cnlohr/esplocalizer/(threads)

Thread 1 (2016-12-31):

Which LDO did you use?

hannes-angst, 2016-12-31:
Can you please expose more information on the parts you used? Especially the LDO you used.

cnlohr, 2017-01-01:
I could go into it more, but I used the MCP1824 to allow seamless switch-over when USB power is provided so it doesn't discharge through the battery when it charges.   There are a lot of other non-latching LDOs with disable, but, I've used the MCP so long, figured I'd just keep using it.

Thread 2 (2017-01-06):

Autoimporting KiCad pretty footprints from hardware/*.sch

brainstorm, 2017-01-06:
Hello @cnlohr,

Thanks much for publishing your projects as open hardware as well as the firmware, always inspiring stuff to learn from you.

I have been trying to reuse your `.sch` since I have a couple of modifications in mind to your design.

Sorry if this sounds obvious (I'm a relatively new KiCad user), but how can I auto-import the footprints for pcbnew without manually importing each `.pretty` library/module? as the KiCad docs state, i.e:

https://github.com/jdunmire/kicad-ESP8266

I thought about giving this giant meta-pretty-repo a shot, but the ESP footprint doesn't seem to be there:

https://github.com/monostable/kicad_footprints

I understand you might be using your existing installation/footprints from past projects, but what would be your advice to semi-automate this process of importing footprints?

brainstorm, 2017-01-06:
I also meant including the `.pro`, `.lib`, etc files from KiCad like in the ESPUSB project:

https://github.com/cnlohr/espusb/tree/master/hardware/usb_8285

Also, totally understand if you don't want to release those yet before monetizing some boards a bit more through ebay, happy to start from scratch myself instead ;)

brainstorm, 2017-01-06:
Hold on a minute... you are adding LoRa (RFM95W radio) to a sister board, that is so cool!!! Exactly what I wanted to do for my own board!

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

Closing this issue since I'm going on my own with KiCad from scratch, but would really appreciate forking/refactoring esplocalizer's hardware (instead of dealing with `??` and unresolved symbols/components from the bare `.sch` file)... is there a kicad-utils script or similar that helps resolving/downloading those?

cnlohr, 2017-01-09:
That seems odd... It should be able to pull the footprints from the cache.   Perhaps I forgot to include the cache?

cnlohr, 2017-01-09:
Looks like I did!  Fixed.

brainstorm, 2017-01-09:
Awesome, thanks Charles! The eeschema looks great now with the cached file (no more `??`'d components). The netlist can be generated without problems but it seems like `Cvpcb` is not liking the part assignments/mappings:

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

cnlohr, 2017-01-09:
I believe most of them are in my public repository here: https://cnlohr.net/pubsvn/electrical/kicad/

Did you tell KiCad to download all footprints locally?  If not, you should.  It should give you the common parts like SM0603 and SOT23-5

brainstorm, 2017-01-09:
Thanks Charles for following this up, super appreciated.

I found that svn a while later exploring, but then I switched to building my own board from scratch since I want to remove/change quite a few components and get more acquainted with KiCad.

Btw, if you ever move that repo to github, let me know, happy to include it to this semi-automated community repo, I've been using it recently, really handy:

https://github.com/monostable/kicad_footprints

cnlohr, 2017-01-09:
I might, but, it's one of those things I like to keep on my own because I know where everything I need is.

Closed 2017-01-06.

Thread 3 (2017-01-20):

Fails to start wifi

fmaurer, 2017-01-20:
New install following instructions, cloned esp82XX-basic example, successfully flash firmware with "make burn" and "make burnweb" (no errors), but doesn't start a wifi hotspot. Serial output on reset shows:

```
esp82XX Web-GUI
Version: v0.1-7-g06742-dev - Build Thu Jan 19 20:05:33 PST 2017 with -DICACHE_FLASH -DWEB_PORT=80 -DCOM_PORT=7777 -DBACKEND_PORT=7878  -DSLOWTICK_MS=5Loading Settings: af / 0 / 69 / 69
Settings Loaded: ESP_930A72 / Default
Opmode: 0
Boot Ok.
```

I'm not sure how to debug why the Opmode would be 0 (wifi off) for this example project. Any pointers would be really helpful, thank you!

On MacOS 10.12

cnlohr, 2017-01-20:
I am not sure how it got into opmode 0.

Try pressing and holding the PGM (GPIO0) button down for about 5 seconds, then releasing.  It should reboot into SoftAP mode.

Charles

fmaurer, 2017-01-20:
You did it! Thank you a million :)  Had to hold closer to 10 seconds but after I let go PGM button wireless AP showed up and serial output:

```
ets Jan  8 2013,rst cause:2, boot mode:(3,7)

load 0x40100000, len 28272, room 16
tail 0
chksum 0x85
load 0x3ffe8000, len 884, room 8
tail 12
chksum 0x59
ho 0 tail 12 room 4
load 0x3ffe8380, len 2612, room 12
tail 8
chksum 0xb2
csum 0xb2
don't use rtc mem data
rlN5
    esp82XX Web-GUI
Version: v0.1-7-g06742-dev - Build Thu Jan 19 20:05:33 PST 2017 with -DICACHE_FLASH -DWEB_PORT=80 -DCOM_PORT=7777 -DBACKEND_PORT=7878  -DSLOWTICK_MS=5Loading Settings: af / 0 / 69 / 69
                Settings Loaded: ESP_930A72 / Default
                                                     Opmode: 2
                                                              Default SoftAP mode: "ESP_930A72":""
                                                                                                  Boot Ok.
                                                                                                          IGMP Joining: 0104a8c0 fb0000e0
```

I'm putting together Mac OS setup guide, will make note of this.

cnlohr, 2017-01-20:
That would be really awesome!  Thanks!

Closed 2017-01-20.

Thread 4 (2017-01-20):

esplocalizer firmware-c example missing files

fmaurer, 2017-01-20:
Cloned esp82XX-basic example compiled and flashed to esp without issue. Everything works great.

Unable to do `make all` in /esplocalizer/firmware-c, compiler missing 'lib' files. What does libmain.a do and where can I get it :) ?

```
xtensa-lx106-elf-gcc: error: /Volumes/case-sensitive/esp-open-sdk/lib/libmain.a: No such file or directory
xtensa-lx106-elf-gcc: error: /Volumes/case-sensitive/esp-open-sdk/lib/liblwip.a: No such file or directory
xtensa-lx106-elf-gcc: error: /Volumes/case-sensitive/esp-open-sdk/lib/libssl.a: No such file or directory
xtensa-lx106-elf-gcc: error: /Volumes/case-sensitive/esp-open-sdk/lib/libupgrade.a: No such file or directory
xtensa-lx106-elf-gcc: error: /Volumes/case-sensitive/esp-open-sdk/lib/libnet80211.a: No such file or directory
xtensa-lx106-elf-gcc: error: /Volumes/case-sensitive/esp-open-sdk/lib/libwpa.a: No such file or directory
xtensa-lx106-elf-gcc: error: /Volumes/case-sensitive/esp-open-sdk/lib/libphy.a: No such file or directory
xtensa-lx106-elf-gcc: error: /Volumes/case-sensitive/esp-open-sdk/lib/liblwip.a: No such file or directory
xtensa-lx106-elf-gcc: error: /Volumes/case-sensitive/esp-open-sdk/lib/libcrypto.a: No such file or directory
xtensa-lx106-elf-gcc: error: /Volumes/case-sensitive/esp-open-sdk/lib/libpp.a: No such file or directory
```

fmaurer, 2017-01-21:
Copied /lib and /ld from here https://github.com/espressif/ESP8266_RTOS_SDK

```
$ make all
/Volumes/case-sensitive/esp-open-sdk/xtensa-lx106-elf/bin/xtensa-lx106-elf-gcc -mlongcalls -Os -I/Volumes/case-sensitive/esp-open-sdk/include -Iesp82xx/include -I. -Iesp82xx/fwsrc -Iuser -DICACHE_FLASH -DWEB_PORT=80 -DCOM_PORT=7777 -DBACKEND_PORT=7878  -DSLOWTICK_MS=50 -DVERSSTR='"Version: 5fb30-dev - Build Fri, 20 Jan 2017 18:35:48 -0800 with -DICACHE_FLASH -DWEB_PORT=80 -DCOM_PORT=7777 -DBACKEND_PORT=7878  -DSLOWTICK_MS=50"' esp82xx/fwsrc/uart.c esp82xx/fwsrc/esp82xxutil.c esp82xx/fwsrc/flash_rewriter.c esp82xx/fwsrc/http.c esp82xx/fwsrc/commonservices.c esp82xx/fwsrc/http_custom.c esp82xx/fwsrc/mdns.c esp82xx/fwsrc/mfs.c user/custom_commands.c user/user_main.c user/i2c.c user/promiscuous.c -flto -Wl,--relax -Wl,--gc-sections -nostdlib -L/Volumes/case-sensitive/esp-open-sdk/lib -L/Volumes/case-sensitive/esp-open-sdk/xtensa-lx106-elf/lib/gcc/xtensa-lx106-elf/4.8.5/libgcc.a /Volumes/case-sensitive/esp-open-sdk/lib/libmain.a /Volumes/case-sensitive/esp-open-sdk/lib/liblwip.a /Volumes/case-sensitive/esp-open-sdk/lib/libssl.a /Volumes/case-sensitive/esp-open-sdk/lib/libupgrade.a /Volumes/case-sensitive/esp-open-sdk/lib/libnet80211.a /Volumes/case-sensitive/esp-open-sdk/lib/libwpa.a /Volumes/case-sensitive/esp-open-sdk/lib/libphy.a /Volumes/case-sensitive/esp-open-sdk/lib/liblwip.a /Volumes/case-sensitive/esp-open-sdk/lib/libcrypto.a /Volumes/case-sensitive/esp-open-sdk/lib/libpp.a /Volumes/case-sensitive/esp-open-sdk/xtensa-lx106-elf/lib/gcc/xtensa-lx106-elf/4.8.5/libgcc.a -T /Volumes/case-sensitive/esp-open-sdk/ld/eagle.app.v6.ld -B/Volumes/case-sensitive/esp-open-sdk/lib  -o image.elf
/Volumes/case-sensitive/esp-open-sdk/xtensa-lx106-elf/lib/gcc/xtensa-lx106-elf/4.8.5/../../../../xtensa-lx106-elf/bin/ld: image.elf section `.text' will not fit in region `iram1_0_seg'
/Volumes/case-sensitive/esp-open-sdk/xtensa-lx106-elf/lib/gcc/xtensa-lx106-elf/4.8.5/../../../../xtensa-lx106-elf/bin/ld: region `iram1_0_seg' overflowed by 3880 bytes
```

I read this had to do with SDK > 1.5.2, but I thought I solved this with esp-open-sdk/Makefile

#VENDOR_SDK = 2.0.0
VENDOR_SDK = 1.5.2

> e.g. with SDK versions greater than 1.5.2, Espressif changed the IRAM management

I'm not sure if coping /lib and /ld was the right thing to do or is even related...

cnlohr, 2017-01-21:
and /include.   Typically I keep the whole SDK together and rename the SDKs.

Indeed that is the issue, however, Espressif made a new SDK that should work again.   You can get a pre-release version of it from here https://github.com/cnlohr/swadges2017 - the file called angus_patch.

Charles

fmaurer, 2017-01-21:
- added /include folder
- downloaded and linked prerelease SDK in esp-open-sdk/Makefile, as seen here:

```
# Vendor SDK version to install, see VENDOR_SDK_ZIP_* vars below
# for supported versions.
VENDOR_SDK = 2.0.0
#VENDOR_SDK = 1.5.2

#...

VENDOR_SDK_ZIP_2.0.0 = REDUCED_ESP8266_NONOS_SDK_2.0.0_20160810_with_angus_patch.zip
VENDOR_SDK_DIR_2.0.0 = REDUCED_ESP8266_NONOS_SDK_2.0.0_20160810_with_angus_patch
#VENDOR_SDK_ZIP_2.0.0 = ESP8266_NONOS_SDK_V2.0.0_16_08_10.zip
#VENDOR_SDK_DIR_2.0.0 = ESP8266_NONOS_SDK_V2.0.0_16_08_10

#the rest of the file...
```

- run `make all `
- cd to /esplocalizer/firmware-c
- `make all` gives same iram error

I'm not understanding where the esp82XX-basic example differs so much from the esplocalizer/firmware-c to produce this behavior. Both project's user.cfg have:

`SDK          = /Volumes/case-sensitive/esp-open-sdk`

Just tried a `make burnweb` using angus SDK and esp82XX-basic produced no errors.

Could you elaborate on "keep the whole SDK together and rename the SDKs" ? Do you keep the esp-open-sdk inside of esplocalizer?

My directory structure looks like this /Volumes/case-sensitive :
- esp-open-sdk
- esp82XX-basic
- esplocalizer

fmaurer, 2017-01-22:
Fixed it:

First was my mistake forgetting command is `make burnweb` while in /esplocalizer/firmware-c

However, this isn't all, it produced the following error:
`Auto-detected Flash size: 32m
Running Cesanta flasher stub...

A fatal error occurred: Invalid head of packet ('\xd8')`

This was fixed by commenting out the following line in /esplocalizer/firmware-c/user.cfg

#FWBURNFLAGS  = -b 1000000

cnlohr, 2017-01-23:
Which dongle do you have?

fmaurer, 2017-01-23:
PL2303 TA based cable, using 2 level shifters for 3.3V and RX

https://www.amazon.com/gp/product/B00QT7LQ88/ref=oh_aui_search_detailpage?ie=UTF8&psc=1

cnlohr, 2017-01-23:
Aah! Ok, I think that one works better at 1,500,000 baud.  Dunno why.

Charles

fmaurer, 2017-01-23:
In my infinite n00bness I have misunderstood many things, but learned much.

make burnweb and make burn accomplish different things. I was able to get burnweb to work as expected, but not `make burn`. This may explain why I couldn't get the fast acc CSV file to work: https://github.com/cnlohr/esplocalizer/issues/5 The esp hasn't been flashed to talk with IMU firmware code. All it has is the web GUI

It's the same `iram1_0_seg` error which I mistook as being fixed by using an older SDK.

My /esp-open-sdk is compiled for 1.5.1, but that still produces same error. Next I'll try cnlohr's suggestion to keep SDK together and rename multiple SDKs.

```
$ make burn
/Volumes/case-sensitive/esp-open-sdk/xtensa-lx106-elf/bin/xtensa-lx106-elf-gcc -mlongcalls -Os -I/Volumes/case-sensitive/esp-open-sdk/include -Iesp82xx/include -I. -Iesp82xx/fwsrc -Iuser -DICACHE_FLASH -DWEB_PORT=80 -DCOM_PORT=7777 -DBACKEND_PORT=7878  -DSLOWTICK_MS=50 -DVERSSTR='"Version: 5fb30-dev - Build Mon, 23 Jan 2017 13:50:12 -0800 with -DICACHE_FLASH -DWEB_PORT=80 -DCOM_PORT=7777 -DBACKEND_PORT=7878  -DSLOWTICK_MS=50"' esp82xx/fwsrc/uart.c esp82xx/fwsrc/esp82xxutil.c esp82xx/fwsrc/flash_rewriter.c esp82xx/fwsrc/http.c esp82xx/fwsrc/commonservices.c esp82xx/fwsrc/http_custom.c esp82xx/fwsrc/mdns.c esp82xx/fwsrc/mfs.c user/custom_commands.c user/user_main.c user/i2c.c user/promiscuous.c -flto -Wl,--relax -Wl,--gc-sections -nostdlib -L/Volumes/case-sensitive/esp-open-sdk/lib -L/Volumes/case-sensitive/esp-open-sdk/xtensa-lx106-elf/lib/gcc/xtensa-lx106-elf/4.8.5/libgcc.a /Volumes/case-sensitive/esp-open-sdk/lib/libmain.a /Volumes/case-sensitive/esp-open-sdk/lib/liblwip.a /Volumes/case-sensitive/esp-open-sdk/lib/libssl.a /Volumes/case-sensitive/esp-open-sdk/lib/libupgrade.a /Volumes/case-sensitive/esp-open-sdk/lib/libnet80211.a /Volumes/case-sensitive/esp-open-sdk/lib/libwpa.a /Volumes/case-sensitive/esp-open-sdk/lib/libphy.a /Volumes/case-sensitive/esp-open-sdk/lib/liblwip.a /Volumes/case-sensitive/esp-open-sdk/lib/libcrypto.a /Volumes/case-sensitive/esp-open-sdk/lib/libpp.a /Volumes/case-sensitive/esp-open-sdk/xtensa-lx106-elf/lib/gcc/xtensa-lx106-elf/4.8.5/libgcc.a -T /Volumes/case-sensitive/esp-open-sdk/ld/eagle.app.v6.ld -B/Volumes/case-sensitive/esp-open-sdk/lib  -o image.elf
/Volumes/case-sensitive/esp-open-sdk/xtensa-lx106-elf/lib/gcc/xtensa-lx106-elf/4.8.5/../../../../xtensa-lx106-elf/bin/ld: image.elf section `.text' will not fit in region `iram1_0_seg'
/Volumes/case-sensitive/esp-open-sdk/xtensa-lx106-elf/lib/gcc/xtensa-lx106-elf/4.8.5/../../../../xtensa-lx106-elf/bin/ld: region `iram1_0_seg' overflowed by 3880 bytes
```

Thread 5 (2017-01-23):

Fast Acc CSV Stream is empty file

fmaurer, 2017-01-23:
I'm having trouble reading the accel and gyro data from a websocket. The default /firmware-c web interface gives a link to the CSV file, but I'm getting 0 bytes or "unable to connect" errors at /d/fastacc.csv

I'm able to create websockets to these endpoints I found in the source:
/d/ws/echo
/d/ws/evaltest
/d/ws/issue

My hunch is I'd have to create a new endpoint: /d/ws/fastacc which the ESP sends websocket packets to connected devices through.

The web interface and fastacc() in /firmware-c/user/user_main.c  looks like the device should already be sending this data, I'm not sure the endpoint to connect to or if this is a problem with my setup.

When I click on the Fast Acc CSV link in web interface, this function should write to socket. 'Save link as' doesn't make a difference:
```
static ICACHE_FLASH_ATTR void fastacc()
{
	//char mydat[128];
	//int len = URLDecode( mydat, 128, curhttp->pathbuffer+8 );

	char buf[1024];
	int times = 20;
	int len = 0;
	int16_t data[10];

	if( first_acc == 1 )
	{
		first_acc = 0;
		len += ets_sprintf( buf+len, "gx, gy, gz, ax, ay, az\r\n" );
	}

	for( ; times > 0 && lsmhead != lsmtail; times -- )
	{
		int16_t * data = &lsmdata[6*lsmtail];
		lsmtail = (lsmtail+1)%LSMBUFFERSIZE;

		len += ets_sprintf( buf+len, "%d, %d, %d, %d, %d, %d\r\n", data[0], data[1], data[2], data[3], data[4], data[5] );
	}

	if( len )
	{
		START_PACK;
		PushBlob( buf, len );
		END_TCP_WRITE( curhttp->socket );
	}

	if( i2cmode == 0 )
	{
		curhttp->state = HTTP_WAIT_CLOSE;
	}

}
```

Thread 6 (2017-04-06):

Missing annotations in schematic ( Component: U5 Regulator )

swapnil823, 2017-04-06:

cnlohr, 2017-04-06:
Which annotations? (Not sure what you mean) Do you mean pertaining to what the part actually is?  An mcp1824?

swapnil823, 2017-04-07:
Yes, An mcp1824.

Closed 2017-04-07.

Thread 7 (2017-09-10):

What is the power consumption in sleep mode?

harmverbeek, 2017-09-10:
Is it < 20 uA?
That would make it a really useful IoT device.

con-f-use, 2017-09-10:
There are different sleep modes in the esp8266, but yes, you can get in the ballpark of that but about everything on the chip will be disabled.

harmverbeek, 2017-09-10:
how about the usb uart chip and the leds?
are they also powered down?

con-f-use, 2017-09-10:
LEDs can be switched of in software or, in case of the power indicator LED desoldered on most ESP8266 modules - not all are the same. I don't know about the UART.

cnlohr, 2017-09-11:
THIS REMINDS ME!  I got permission to post a study I did on the sleeping options for the ESP on the esplocalizer!  It's really rough and totally not publish ready but here is a link to the google drive and some of the code I used.

https://drive.google.com/open?id=0B-rO-WAvEtVBU1FSOVRKZ3Npc1U

TL;DR:
 * Deep sleep on esplocaizer is 0.9mA
 * Sleeping, waiting for a GPIO wakeup is 1.8mA
 * Disconnected-from-wifi @pvvx light-sleep or as I call it "crazy sleep" where the processor is still running but not very utilized is 3.5-5.5mA depending on work load.  Thanks @pvvx you are one awesome dude.
 * Wifi on, light sleep ~12mA
 * Full bore: 72mA

cnlohr, 2017-09-11:
The real killer for suuuper tiny power consumption on this board is a combination of the regulators, and static uses.  I don't actually know how much the LEDs use, but it's not much.

harmverbeek, 2017-09-11:
0.9mA is 90 times too much for a battery powered sensor ;)
That's the problem with all sensor boards that include a USB UART chip, regulators and leds.
You have got to find a way to at least switch off the UART chip when not used.

cnlohr, 2017-09-12:
This board does not include the uart chip on it.  USB on here is strictly for power.  It's everything else on-board, including the lithium ion charging circuit.

Thread 8 (2018-02-25):

Arduino build error

meule, 2018-02-25:
When I build esp_10dof.ino using Arduini 1.8.5 I get the error:
```/var/folders/53/6tzgtd453hzgcg2hsv9j353w0000gn/T/arduino_build_876699/sketch/esp_10dof.ino.cpp.o:(.text._Z12sensor_setupv+0x10): undefined reference to `LSM9DS1::begin()'
/var/folders/53/6tzgtd453hzgcg2hsv9j353w0000gn/T/arduino_build_876699/sketch/esp_10dof.ino.cpp.o: In function `sensor_setup()':
/Users/Kostia/drive/Dropbox/ec2/gled/esplocalizer/firmware-arduino/esp_10dof/esp_10dof.ino:106: undefined reference to `LSM9DS1::begin()'
/var/folders/53/6tzgtd453hzgcg2hsv9j353w0000gn/T/arduino_build_876699/sketch/esp_10dof.ino.cpp.o: In function `printData()':
/Users/Kostia/drive/Dropbox/ec2/gled/esplocalizer/firmware-arduino/esp_10dof/esp_10dof.ino:165: undefined reference to `getAccel(bool)'
/Users/Kostia/drive/Dropbox/ec2/gled/esplocalizer/firmware-arduino/esp_10dof/esp_10dof.ino:165: undefined reference to `getGyro(bool)'
/Users/Kostia/drive/Dropbox/ec2/gled/esplocalizer/firmware-arduino/esp_10dof/esp_10dof.ino:166: undefined reference to `getMag(bool)'
/Users/Kostia/drive/Dropbox/ec2/gled/esplocalizer/firmware-arduino/esp_10dof/esp_10dof.ino:167: undefined reference to `getAccel(bool)'
/Users/Kostia/drive/Dropbox/ec2/gled/esplocalizer/firmware-arduino/esp_10dof/esp_10dof.ino:168: undefined reference to `getGyro(bool)'
/var/folders/53/6tzgtd453hzgcg2hsv9j353w0000gn/T/arduino_build_876699/sketch/esp_10dof.ino.cpp.o: In function `loop':
/Users/Kostia/drive/Dropbox/ec2/gled/esplocalizer/firmware-arduino/esp_10dof/esp_10dof.ino:168: undefined reference to `getMag(bool)'
/Users/Kostia/drive/Dropbox/ec2/gled/esplocalizer/firmware-arduino/esp_10dof/esp_10dof.ino:171: undefined reference to `LSM9DS1::LSM9DS1()'
/Users/Kostia/drive/Dropbox/ec2/gled/esplocalizer/firmware-arduino/esp_10dof/esp_10dof.ino:174: undefined reference to `LSM9DS1::LSM9DS1()'
collect2: error: ld returned 1 exit status```

How to fix it?

per1234, 2018-02-26:
@meule, please post a directory listing or screenshot of the contents of both:
/Users/Kostia/drive/Dropbox/ec2/gled/esplocalizer/firmware-arduino/esp_10dof/
and
/Users/Kostia/drive/Dropbox/ec2/gled/esplocalizer/firmware-arduino/

@cnlohr the Arduino IDE automatically concatenates all .ino files in the sketch folder before compilation so nothing special is required.

My suspicion is that the root cause of the problem is the sketch filename not matching the sketch folder name but ordinarily that would cause a "fatal error: lsm9ds1.h: No such file or directory" error so I could be wrong.

Thread 10 (2020-02-23):

Missing PCB file in hardware

mike-a-fischer, 2020-02-23:
I would like recreate this device but the hardware section is missing the pcb file. Could it be included in the repository?

thecrazy, 2021-12-12:
Since you are no longer selling it, that would be nice.
