cnlohr/esplocalizer/hardware/esplocalizer-tight-F.pdf

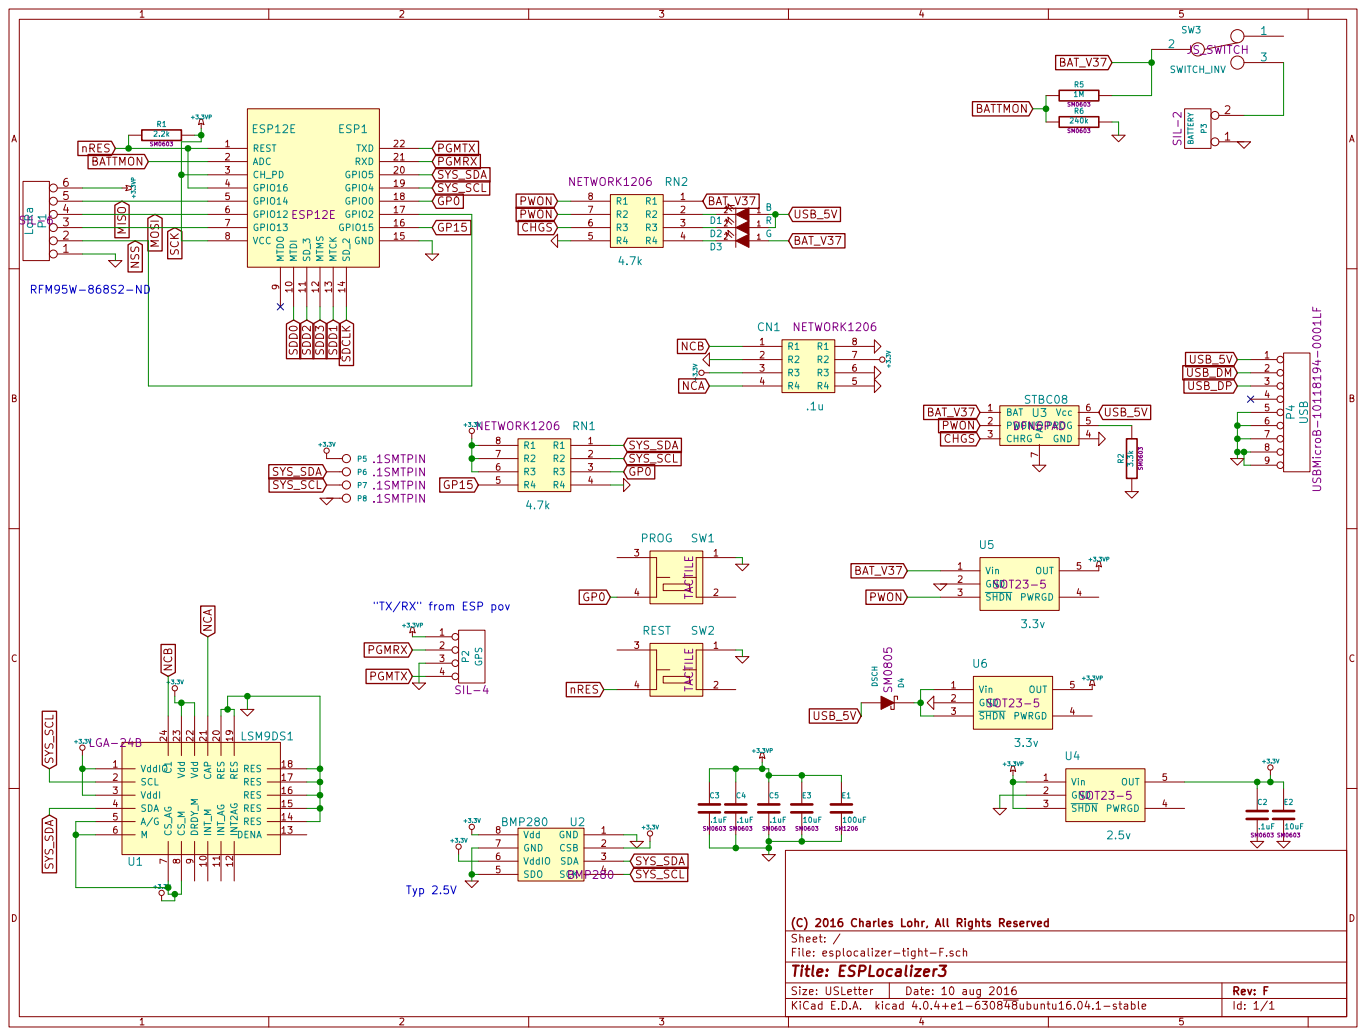
[picture p3: page 1]

9 MTDI 10 GPIO5 20 SD_3 11 RXD 21 MTMS 12 TXD 22 MTCK 13 SD_2 14 GND 15 GPIO15 16 GPIO2 17 GPIO0 18 GPIO4 19 ESP12E ESP1

"TX/RX" from ESP pov

9 INT_M 10 RES 20 INT_AG 11 CAP 21 INT2AG 12 Vdd 22 DENA 13 Vdd 23 RES 14 C1 24 RES 15 RES 16 RES 17 RES 18 RES 19 U1

File: esplocalizer-tight-F.sch Sheet: / (C) 2016 Charles Lohr, All Rights Reserved
