cnlohr/esplocalizer/hardware/esplocalizer-tight-F.sch

## KiCad design hardware/esplocalizer-tight-F.sch (2016-12-24)

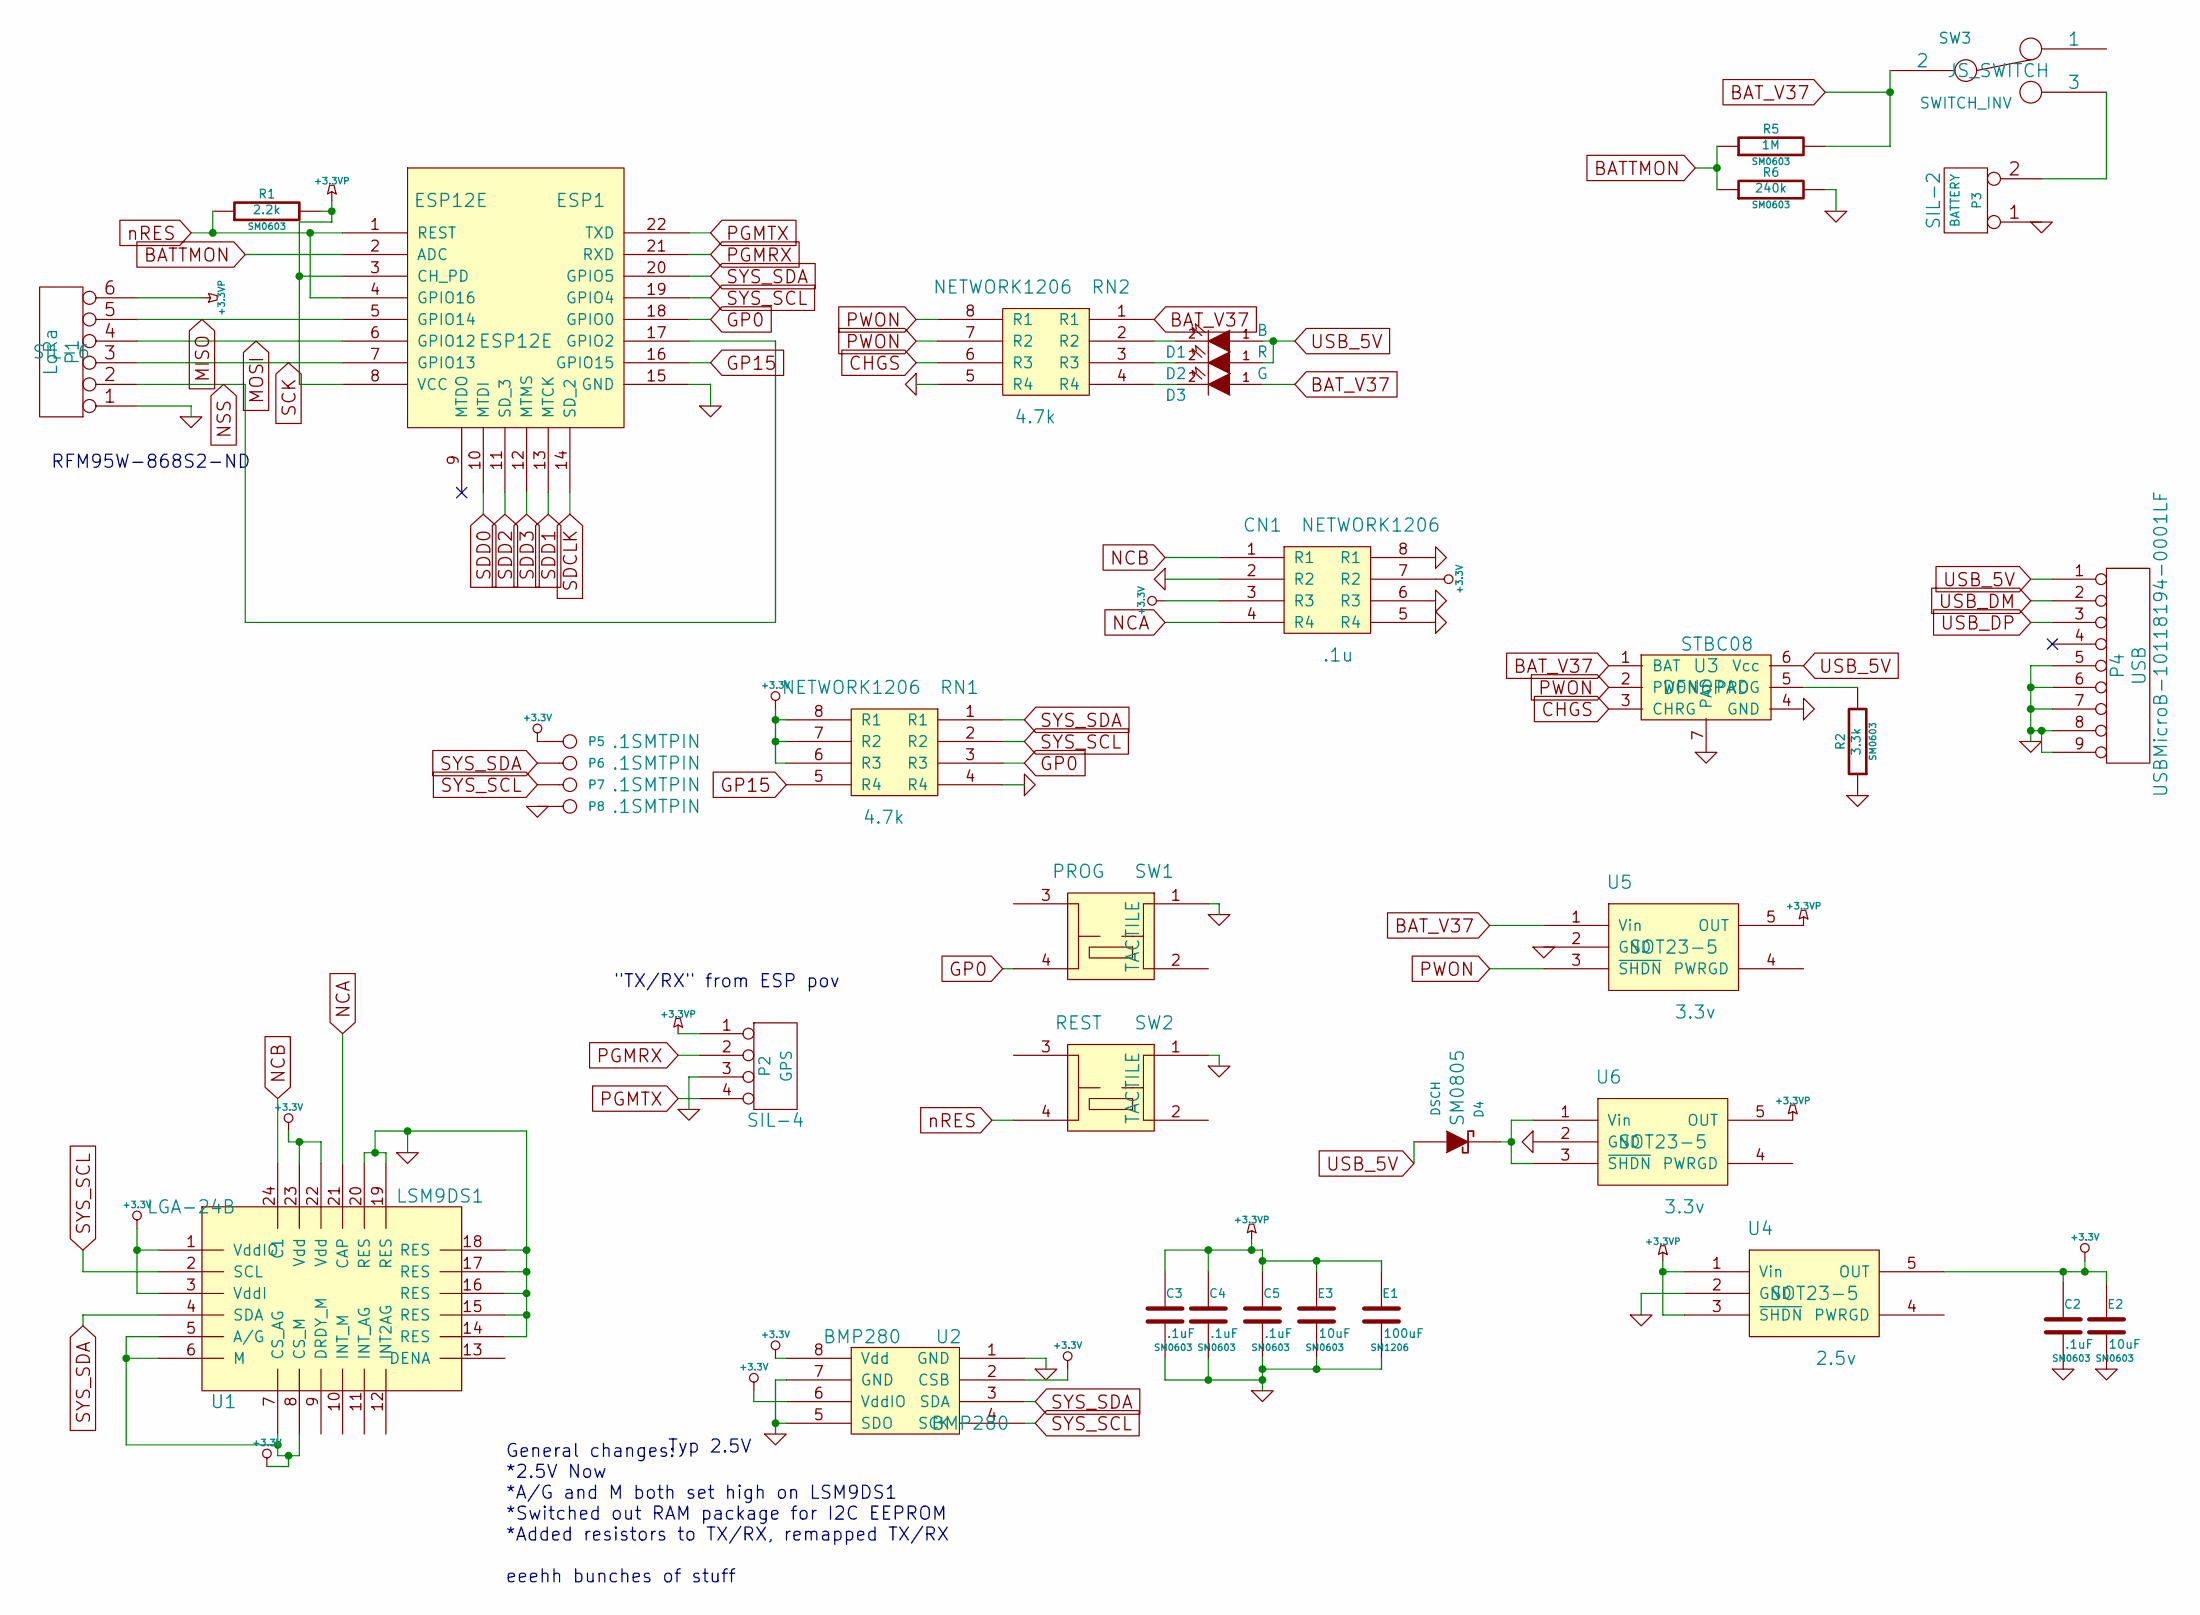
[picture p4: schematic esplocalizer-tight-F.sch]

Parts:
C2, C3, C4, C5: .1uF; SM0603; Digikey 1276-1012-1-ND
CN1: .1u; NETWORK1206; Digikey 1276-2741-1-ND
D1: B; SM0805; Digikey 732-4981-1-ND
D2: R; SM0805; Digikey 732-4978-1-ND
D3: G; SM0805; Digikey 732-4971-1-ND
D4: DSCH; SM0805; Digikey 478-7802-1-ND
E1: 100uF; SM1206; Digikey 587-3395-1-ND
E2, E3: 10uF; SM0603; Digikey 1276-1119-1-ND
ESP1: ESP12E
P1: LoRa; SIL-6; Digikey S1011EC-06-ND
P2: GPS; SIL-4; Digikey 952-2265-ND
P3: BATTERY; SIL-2
P4: USB; USBMicroB-10118194-0001LF; Digikey 609-4618-1-ND
P5: 2.5V; .1SMTPIN
P6: SDA; .1SMTPIN
P7: SCL; .1SMTPIN
P8: GND; .1SMTPIN
R1: 2.2k; SM0603; Digikey 311-2.20KGRCT-ND
R2: 3.3k; SM0603; Digikey 311-3.30KHRCT-ND
R5: 1M; SM0603; Digikey 311-1.00MHRCT-ND
R6: 240k; SM0603; Digikey 311-240KHRCT-ND
RN1, RN2: 4.7k; NETWORK1206; Digikey YC164J-4.7KCT-ND
SW1: PROG; TACTILE; Digikey EG4621CT-ND
SW2: REST; TACTILE; Digikey EG4621CT-ND
SW3: SWITCH_INV; JS_SWITCH; Digikey 401-1999-1-ND
U1: LSM9DS1; LGA-24B; Digikey 497-14946-1-ND
U2: BMP280
U3: STBC08; DFN6PAD; Digikey 497-5808-1-ND
U4: 2.5v; SOT23-5; Digikey MCP1824T-2502E/OTCT-ND
U5, U6: 3.3v; SOT23-5; Digikey MCP1824T-3302E/OTCT-ND

Connections:
+3.3V: C2.1, CN1.3 (R3), CN1.7 (R2), E2.1, P5.1, RN1.6 (R3), RN1.7 (R2), RN1.8 (R1), U1.1 (VddIO), U1.3 (VddI), U1.5 (A/G), U1.6 (M), U1.7 (CS_AG), U1.8 (CS_M), U1.22 (Vdd), U1.23 (Vdd), U2.2 (CSB), U2.6 (VddIO), U2.8 (Vdd), U4.5 (OUT)
+3.3VP: C3.1, C4.1, C5.1, E1.1, E3.1, ESP1.3 (CH_PD), ESP1.8 (VCC), P1.6, P2.1, R1.2, U4.1 (Vin), U4.3 (~SHDN), U5.5 (OUT), U6.5 (OUT)
BATTMON: ESP1.2 (ADC), R5.1, R6.1
BAT_V37: D3.1 (A), R5.2, RN2.1 (R1), SW3.2, U3.1 (BAT), U5.1 (Vin)
CHGS: RN2.6 (R3), U3.3 (CHRG)
GND: C2.2, C3.2, C4.2, C5.2, CN1.2 (R2), CN1.5 (R4), CN1.6 (R3), CN1.8 (R1), E1.2, E2.2, E3.2, ESP1.15 (GND), P1.1, P2.3, P3.1, P4.5, P4.6, P4.7, P4.8, P4.9, P8.1, R2.1, R6.2, RN1.4 (R4), RN2.5 (R4), SW1.1, SW2.1, U1.14 (RES), U1.15 (RES), U1.16 (RES), U1.17 (RES), U1.18 (RES), U1.19 (RES), U1.20 (RES), U2.1 (GND), U2.5 (SDO), U2.7 (GND), U3.4 (GND), U3.7 (PAD), U4.2 (GND), U5.2 (GND), U6.2 (GND)
GP0: ESP1.18 (GPIO0), RN1.3 (R3), SW1.4
GP15: ESP1.16 (GPIO15), RN1.5 (R4)
MISO: ESP1.5 (GPIO14), P1.5
MOSI: ESP1.6 (GPIO12), P1.4
NCA: CN1.4 (R4), U1.21 (CAP)
NCB: CN1.1 (R1), U1.24 (C1)
NSS: ESP1.17 (GPIO2), P1.2
unnamed: D1.2 (K), RN2.2 (R2)
unnamed: D2.2 (K), RN2.3 (R3)
unnamed: D3.2 (K), RN2.4 (R4)
unnamed: D4.2 (K), U6.1 (Vin), U6.3 (~SHDN)
unnamed: P3.2 (PM), SW3.3
unnamed: R2.2, U3.5 (PROG)
PGMRX: ESP1.21 (RXD), P2.2
PGMTX: ESP1.22 (TXD), P2.4
PWON: RN2.7 (R2), RN2.8 (R1), U3.2 (PWON), U5.3 (~SHDN)
SCK: ESP1.7 (GPIO13), P1.3
SDCLK: ESP1.14 (SD_2)
SDD0: ESP1.10 (MTDI)
SDD1: ESP1.13 (MTCK)
SDD2: ESP1.11 (SD_3)
SDD3: ESP1.12 (MTMS)
SYS_SCL: ESP1.19 (GPIO4), P7.1, RN1.2 (R2), U1.2 (SCL), U2.4 (SCK)
SYS_SDA: ESP1.20 (GPIO5), P6.1, RN1.1 (R1), U1.4 (SDA), U2.3 (SDA)
USB_5V: D1.1 (A), D2.1 (A), D4.1 (A), P4.1, U3.6 (Vcc)
USB_DM: P4.2
USB_DP: P4.3
nRES: ESP1.1 (REST), ESP1.4 (GPIO16), R1.1, SW2.4

Notes on the sheet:
Typ 2.5V
"TX/RX" from ESP pov
General changes: *2.5V Now *A/G and M both set high on LSM9DS1 *Switched out RAM package for I2C EEPROM *Added resistors to TX/RX, remapped TX/RX eeehh bunches of stuff
RFM95W-868S2-ND
