cnlohr/esplocalizer/(commit log)

2017-01-09 Forgot to include he cache file that contains the schematic components.
2017-03-14 move out the existing esp82xx
    [esp12f-generics.kicad_pcb, esp12f-generics.sch]
2017-03-14 Switch to new SDK.
    [user.cfg]
2018-05-29 Move sketch to appropriately named subfolder
    The Arduino IDE requires that a sketch be located in a folder of the same name.
    When opening a file that does not meet this sketch/folder name matching requirement the Arduino IDE presents a dialog:
    The file "esp_10dof.ino" needs to be inside a sketch folder named "esp_10dof".
    Create this folder, move the file, and continue?
    After clicking "OK" the Arduino IDE currently moves only the file esp_10dof.ino to the new folder, leaving behind the other source files. This causes compilation of the sketch to fail:
    esplocalizer-master\firmware-arduino\esp_10dof\esp_10dof.ino:15:21: fatal error: lsm9ds1.h: No such file or directory
    #include "lsm9ds1.h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
    [bmp280.cpp, bmp280.h, esp_10dof.ino, imu.h, imu.ino, lsm9ds1.h, lsm9ds1.ino, lsm9ds1_reg.h]
